dalemi666/ArduinoELS/(commit log)

2022-11-28 Spostato in README.md tutto il contenuto di wiki
2022-11-28 Spostato il file LICENCE.md
2022-11-28 - Aggiunta la variabile distOneRev per indicare la distanza percorsa dal carro per ogni giro della madrevite. - Aggiornati i commenti relativi ai parametri da mofificare dagli utent: >latheEncRes >se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
2022-11-28 Inserite foto relative al montaggio degli encoders sul mio tornio
